MrZhouWang/HoFon-800U-R3N3/2016.07.25 800U-R3N3/hardware/2016.08.11/800U R3N3_LED_V1.0(1).PcbDoc.htm

Reporting Options

# File in Previous Format

Date | : | 2016/8/28
Time | : | 8:42:52
Filename | : | E:\公司项目\2016.07.25 800U-R3N3\hardware\2016.08.11\800U R3N3_LED_V1.0(1).PcbDoc

Version | Warning
Altium Designer update 19 | CAUTION - Air Gap Width attribute was introduced to Polygon Connect Style Rule. Air Gap Width attribute now controls the distance between poured polygon and pads on the same net - this value was previosuly taken from clearance rule while ignoring net subscope leading to sometime unexpected results.
Release 13 | CAUTION - Silkscreen Over Component Pads Rules are converted to Silk To Solder Mask Clearance Rules. Suggest examining rule scopes for accuracy.

This file was generated by an earlier version of the software
