MrZhouWang/HoFon-800U-R3N3/2016.07.25 800U-R3N3/hardware/M18图纸/M18PNP新 - 副本.PCBDOC.htm

Reporting Options

# File in Previous Format

Date | : | 2016/7/25
Time | : | 11:09:03
Filename | : | E:\公司项目\800U-R3N3\M18图纸\M18PNP新 - 副本.PCBDOC

Version | Warning
Summer 09 | CAUTION - File contains old violation objects. These violations are no longer supported & will not be loaded. Please run DRC after opening this file in order to refresh the violations.
Summer 09 | CAUTION - Existing testpoint rules and settings are used as fabrication testpoint information.
Altium Designer update 19 | CAUTION - Air Gap Width attribute was introduced to Polygon Connect Style Rule. Air Gap Width attribute now controls the distance between poured polygon and pads on the same net - this value was previosuly taken from clearance rule while ignoring net subscope leading to sometime unexpected results.
Release 13 | CAUTION - Silkscreen Over Component Pads Rules are converted to Silk To Solder Mask Clearance Rules. Suggest examining rule scopes for accuracy.

This file was generated by an earlier version of the software
