MrZhouWang/HoFon-800U-R3N3/2016.07.25 800U-R3N3/documents/800U R3N3_SENSOR_V1.3 BOM表.xlsx

 |  |  |  |  |  |  |  | 表 号
 |  |  |  |  |  |  |  | 版本/换页
 |  |  |  |  |  |  |  | 页 码 | /
产品名称 |  | 800U R3N3 |  |  | 产品型号 | 800U R3N3_SENSOR_V1.3 |  | 编制/日期 | 201608019
版本号 |  |  |  |  | 物料类别 | 电子料 |  | 审批/日期
序号 | 物料编号 |  | 物料名称 | 规格、型号 |  | 封装 | 位号 |  | 数量 | 备注
 |  |  | 800U R3N3_ SONSER_V1.3 | FR4 |  |  |  |  | 1
 |  |  | 发射二极管 | SIR67-21C |  | 3528 | LED1 |  | 1 | 亿光
 |  |  | 接收二极管 | PD70-01C |  |  | RE1 |  | 1 | 亿光
 |  |  | 贴片三极管 | MMBT5551 |  | SOT-23 | Q1 |  | 1
 |  |  | 贴片电容 | 1uF/50V |  | C0603 | C1 C2 |  | 2
 |  |  | 贴片电容 | 1nF |  | C0603 | C3 |  | 1
 |  |  | 贴片电阻 | 10K |  | R0603 | R4 |  | 1
 |  |  | 贴片电阻 | 100R |  | R0805 | R1 R2 |  | 2
 |  |  | 贴片电阻 | 50R |  | R0805 | R5 |  | 1
