MrZhouWang/HoFon-800U-R3N3/2016.07.25 800U-R3N3/hardware/原理图/800U-R3N3-Test.xls

Description | Comment | Footprint | Quantity | Designator
贴片电容 | 105 | C0805 | 1 | C1
贴片电容 | 105 | C0603 | 2 | C2, C10
贴片电容 | 104 | C0603 | 4 | C3, C7, C9, C14
贴片电容 | 102 | C0603 | 4 | C4, C5, C6, C8
贴片电容 | 1uF/50V | C0603 | 1 | C11
贴片电容 | 10uF | C0603 | 2 | C12, C13
贴片RBG发光管 | 5050RGB | 5050RGB | 8 | D1, D2, D3, D4, D5, D6, D7, D8
贴片桥堆 | LX10M | 桥堆 3.8*3.5 | 1 | D9
贴片TVS | TVS36V | D1206 | 2 | D10, D11
贴片红外发射管 | SIR67-21C | LED-3.5X2.8 | 1 | LED1
 |  | HOLE_SMD | 4 | OUT1, SIN1, VIN+1, VIN-1
插座 | 3P 2.0mm | PIN3-2.0mm | 1 | P1
贴片NPN三极管 | MMBT5551 | SOT-23 | 5 | Q1, Q2, Q3, Q4, Q6
贴片PNP三极管 | S8550 | SOT-23 | 1 | Q5
NPN三极管 | 贴片三极管 | SOT-23 | 1 | Q7
贴片电阻 | 100 | R0805 | 1 | R1
贴片电阻 | 100 | R0603 | 1 | R2
贴片电阻 | 390K | R0603 | 1 | R3
贴片电阻 | 100K | R0603 | 1 | R4
贴片电阻 | 0R | R0603 | 9 | R5, R6, R22, R24, R26, R34, R36, R38, R53
贴片电阻 | 10K | R0603 | 10 | R7, R8, R10, R42, R43, R44, R45, R47, R48, R51
贴片电阻 | 22 | R0603 | 1 | R9
贴片电阻 | 5K6 | R0603 | 2 | R11, R14
贴片电阻 | 2K | R0603 | 2 | R12, R54
贴片电阻 | 15 | R0805 | 1 | R13
贴片电阻 | 510 | 2010 | 2 | R15, R27
贴片电阻 | 300 | 2010 | 4 | R16, R17, R28, R29
贴片电阻 |  | 2010 | 6 | R18, R19, R20, R30, R31, R32
贴片电阻 |  | R0603 | 6 | R21, R23, R25, R33, R35, R37
贴片电阻 | 150 | 2010 | 3 | R39, R40, R41
贴片电阻 | 750R | 2010 | 1 | R46
贴片电阻 | 240 | R0603 | 1 | R49
贴片过流保护 | SMD1206P016 | 1206 | 2 | R50, R52
贴片电阻 | 400 | R0603 | 1 | R55
贴片接收管 | PD70-01C | LED-1210 | 1 | RE1
贴片可调电阻 |  | POT4MM-2 | 1 | RJ1
贴片芯片 | TP2312 | SO-8 | 1 | U1
贴片芯片 | C8051F300 | IC3-3-14P | 1 | U2
贴片芯片 | LM317AEMP | MP04A_N | 1 | U3
