MrZhouWang/HoFon-800U-R3N3/2016.07.25 800U-R3N3/生产输出/800U R3N3_LED_V1.3 BOM表.xlsx

物料清单（BOM） |  |  |  |  |  |  |  | 表 号
 |  |  |  |  |  |  |  | 版本/换页
 |  |  |  |  |  |  |  | 页 码 | /
产品名称 |  | 800U R3N3 |  |  | 产品型号 | 800U R3N3_LED_V1.3 |  | 编制/日期 | 20160819
版本号 |  |  |  |  | 物料类别 | 电子料 |  | 审批/日期
序号 | 物料编号 |  | 物料名称 | 规格、型号 |  | 封装 | 位号 |  | 数量 | 备注
1 |  |  | 800U R3N3_ LED_V1.3 | FR4 |  |  |  |  | 1
2 |  |  | 贴片芯片 | C8051F300 |  | QFN-11 | U2 |  | 1
3 |  |  | 贴片芯片 | OPA2337 |  | SOP-8 | U3 |  | 1 | TI
4 |  |  | 贴片芯片 | L22674 |  | SO-1.27-9/4.0 | U1 |  | 1
5 |  |  | 贴片芯片 | SP6205 |  | SOT-23-5 | U4 |  | 1
7 |  |  | 贴片三极管 | MMBT5551 |  | SOT-23 | Q1 Q6 |  | 2
8 |  |  | MOS管 | SI2301CDS |  | SOT-23 | Q3 Q4 Q5 |  | 3
9 |  |  | 桥堆 | LX10M |  |  | D4 |  | 1
10 |  |  | 贴片二极管 | SS14 |  | SMB | D1 |  | 1
11 |  |  | 贴片二极管 | TVS36V |  | HSMA | D2 D3 |  | 2
12 |  |  | 贴片电感 | 68uH |  | L-6X6 | L1 |  | 1
13 |  |  | 贴片发光二极管 | 5050RGB |  | 5050 | D5 D6 D7 D8 D9 D10 D11 D12 |  | 8
14 |  |  | 可恢复保险丝 | FSMD012-1206-R |  | R1206 | F1 F2 |  | 2
15 |  |  | 贴片电容 | 33uF/16V |  | CT3528 | C2 |  | 1
16 |  |  | 直插铝电解电容 | 22uF/50V |  | 5*11 | CT1 |  | 1
17 |  |  | 贴片电容 | 4.7uF |  | C0603 | C13 C14 |  | 2
18 |  |  | 贴片电容 | 1uF/50V |  | C0603 | C7 |  | 1
19 |  |  | 贴片电容 | 100nF |  | C0603 | C4 C9 C10 C11 C12 |  | 5
20 |  |  | 贴片电容 | 10nF |  | C0603 | C1 C3 |  | 2
21 |  |  | 贴片电容 | 1nF |  | C0603 | C5 C6 C8 |  | 3
22 |  |  | 贴片电阻 | 0R |  | R0603 | R3 R8 R13 R30 |  | 4
23 |  |  | 贴片电阻 | 150R |  | R0805 | R17 R32 R35 R38 R41 R44 R48 R51 |  | 8
24 |  |  | 贴片电阻 | 100R |  | R0805 | R25 R31 R34 R37 R40 R43 R47 R50 |  | 8
25 |  |  | 贴片电阻 | 220R |  | R0805 | R18 R33 R36 R39 R42 R45 R49 R52 |  | 8
26 |  |  | 贴片电阻 | 1K |  | R0603 | R4 R19 R21 |  | 3
27 |  |  | 贴片电阻 | 1.62K/1% |  | R0603 | R11 |  | 1
28 |  |  | 贴片电阻 | 4.75K/1% |  | R0603 | R9 |  | 1
29 |  |  | 贴片电阻 | 10K |  | R0603 | R1 R5 R6 R12 R20 R22 R26 |  | 7
30 |  |  | 贴片电阻 | 11.8K |  | R0603 | R10 |  | 1
31 |  |  | 贴片电阻 | 100K |  | R0603 | R7 |  | 1
32 |  |  | 贴片电阻 | 100K |  | R0603 | R2 |  | 1
33 |  |  | 贴片电阻 | 4.7K |  | R0603 | R14 R16 |  | 2
34 |  |  | 贴片电阻 | 3K |  | R0603 | R27 |  | 1
35 |  |  | 贴片电阻 | 2K |  | R0603 | R15 R29 |  | 2
 | NPN输出焊接器件
36 |  |  | 贴片电阻 | 0R |  | R0603 | R28 |  | 1
注：36和37取一焊接 选择NPN或者PNP输出 按客户需求
 | PNP输出焊接器件
37 |  |  | 贴片三极管 | S8550 |  | SOT-23 | Q2 |  | 1
 |  |  | 贴片电阻 | 10K |  | R0603 | R23 R24 |  | 2
