MrZhouWang/HoFon-800U-R3N3/2016.07.25 800U-R3N3/hardware/结构/800ur3n3 2016-06-20/塑件开模/800uR3N3透镜筒_ (2).stp

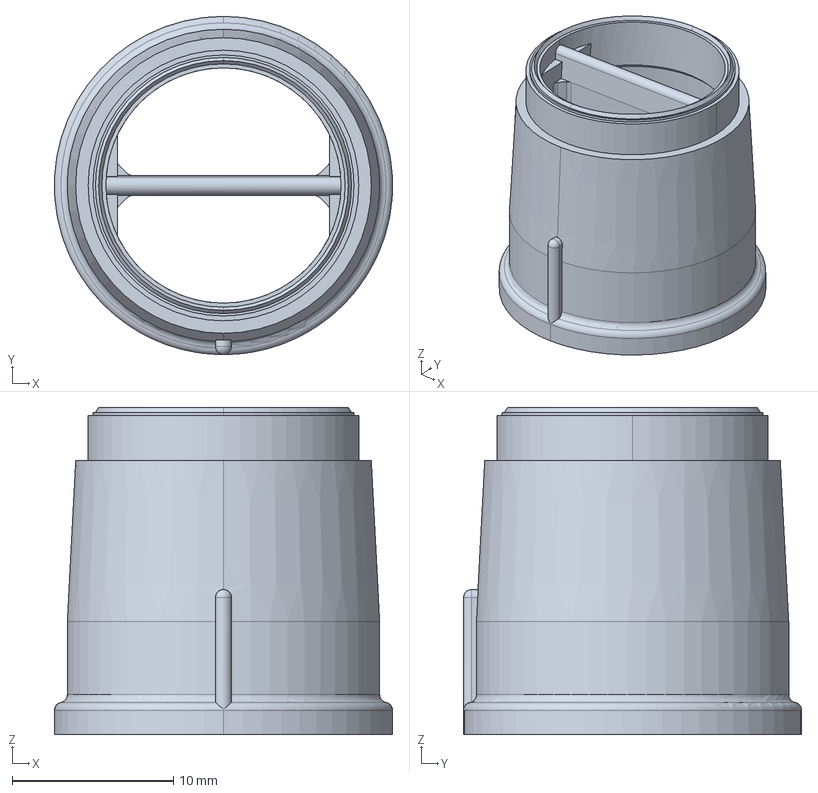
[picture p36: CAD file, 2016-11-21]
2016.07.25 800U-R3N3/hardware/结构/800ur3n3 2016-06-20/塑件开模/800uR3N3透镜筒_ (2).stp
21.0 x 21.0 x 20.3 mm
