MrZhouWang/HoFon-800U-R3N3/2016.07.25 800U-R3N3/hardware/结构/800ur3n32016-07-01/塑件开模/800u_r3n3__灯罩.stp

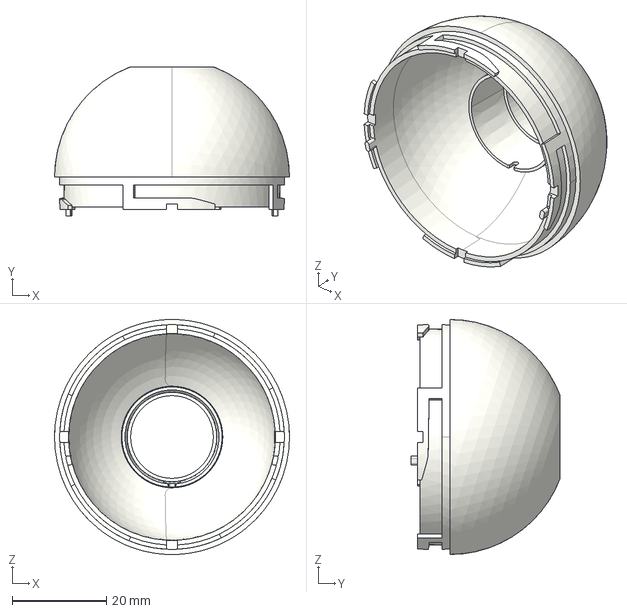
[picture p37: CAD file, 2016-11-21]
2016.07.25 800U-R3N3/hardware/结构/800ur3n32016-07-01/塑件开模/800u_r3n3__灯罩.stp
50.0 x 31.8 x 50.0 mm
