MrZhouWang/HoFon-800U-R3N3/2016.07.25 800U-R3N3/hardware/结构/塑件开模/800UR3N3透镜.stp

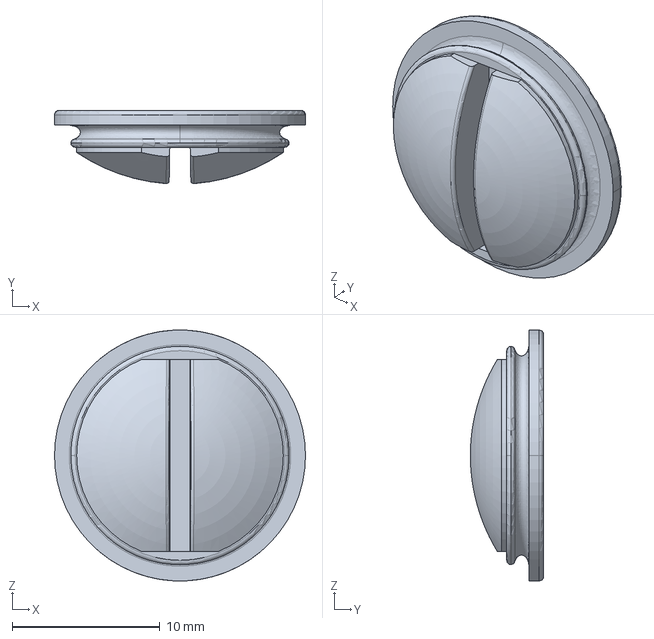
[picture p38: CAD file, 2016-11-21]
2016.07.25 800U-R3N3/hardware/结构/塑件开模/800UR3N3透镜.stp
17.0 x 4.96 x 17.0 mm
