MrZhouWang/HoFon-800U-R3N3/2016.07.25 800U-R3N3/hardware/结构/800ur3n3 2016-06-20/塑件开模/800u___按键灯罩 (2).stp

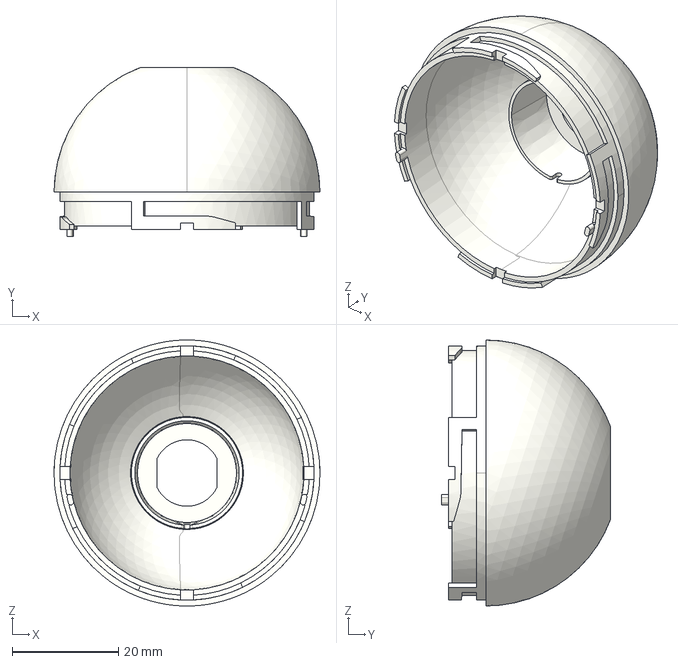
[picture p39: CAD file, 2016-11-21]
2016.07.25 800U-R3N3/hardware/结构/800ur3n3 2016-06-20/塑件开模/800u___按键灯罩 (2).stp
50.0 x 31.9 x 50.0 mm
