MrZhouWang/HoFon-800U-R3N3/2016.07.25 800U-R3N3/hardware/结构/800ur3n32016-07-01/塑件开模/800uR3N3透镜筒.stp

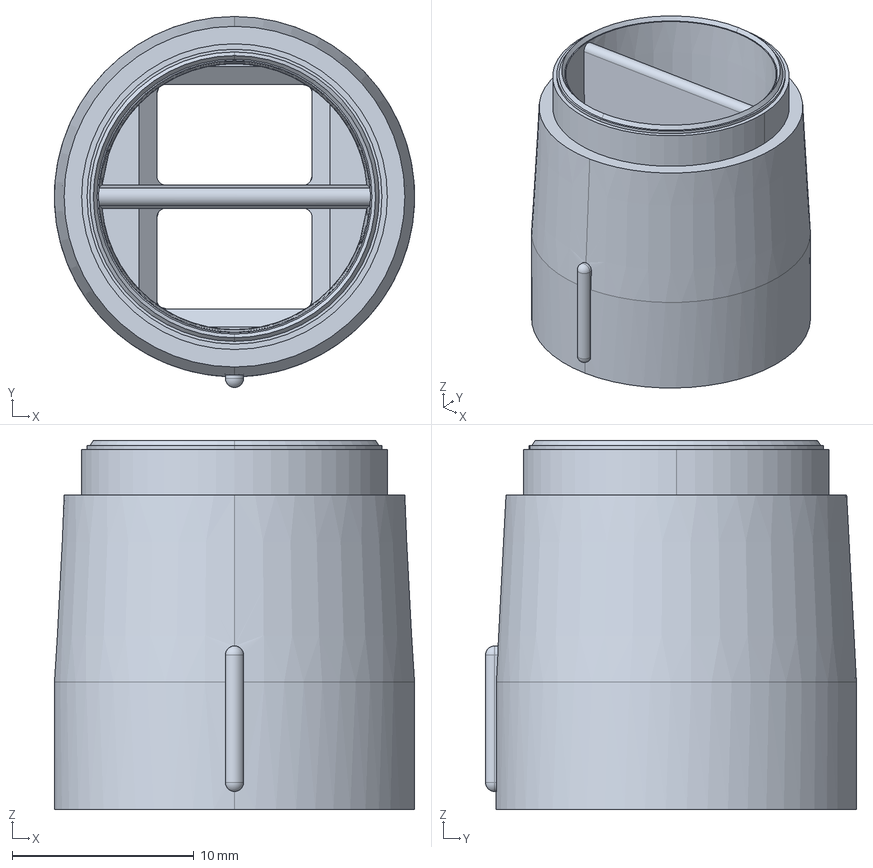
[picture p40: CAD file, 2016-11-21]
2016.07.25 800U-R3N3/hardware/结构/800ur3n32016-07-01/塑件开模/800uR3N3透镜筒.stp
19.8 x 20.4 x 20.3 mm
