MrZhouWang/HoFon-800U-R3N3/2016.07.25 800U-R3N3/hardware/结构/800ur3n3 2016-06-20/塑件开模/800UR3N3透镜 (2).stp

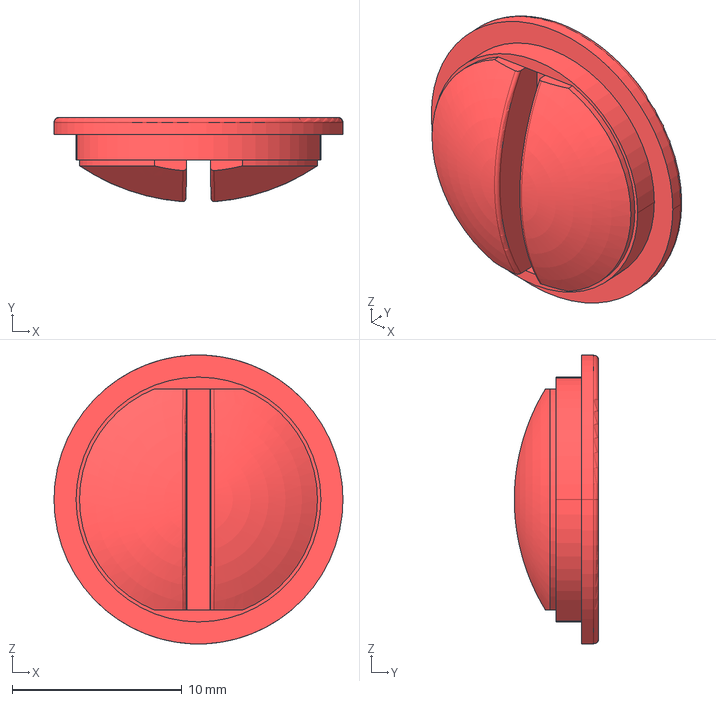
[picture p41: CAD file, 2016-11-21]
2016.07.25 800U-R3N3/hardware/结构/800ur3n3 2016-06-20/塑件开模/800UR3N3透镜 (2).stp
17.0 x 4.96 x 17.0 mm
