MrZhouWang/HoFon-800U-R3N3/2016.07.25 800U-R3N3/hardware/结构/800ur3n32016-07-01/塑件开模/800UR3N3透镜.stp

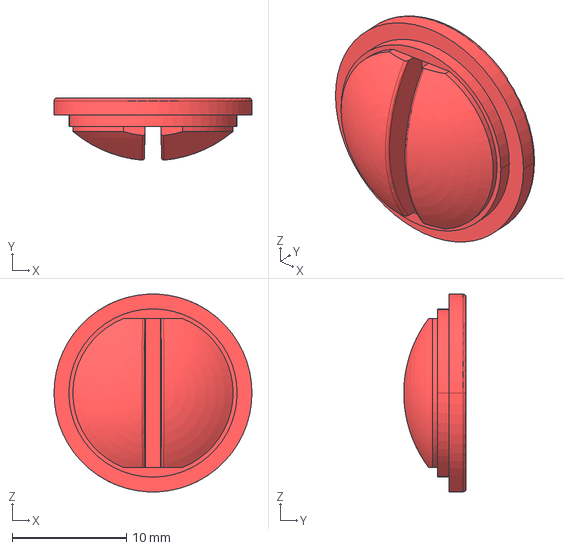
[picture p42: CAD file, 2016-11-21]
2016.07.25 800U-R3N3/hardware/结构/800ur3n32016-07-01/塑件开模/800UR3N3透镜.stp
17.3 x 5.46 x 17.3 mm
