MrZhouWang/HoFon-800U-R3N3/(list of files, cad)

Other CAD files:
2016.07.25 800U-R3N3/firmware/800U-P3N3-T3N3 IO_V2.1_20151013 定制/UV4/main.obj
2016.07.25 800U-R3N3/firmware/800U-R3B3程序 - 2016-8-18/PRO/main.obj
2016.07.25 800U-R3N3/firmware/800U-R3B3程序 - 2016-8-08/PRO/main.obj
2016.07.25 800U-R3N3/firmware/800U-R3B3程序 - 2016-9-11/PRO/main.obj
2016.07.25 800U-R3N3/firmware/800U-R3B3程序 - 2016-10-26-绝对值/PRO/main.obj
2016.07.25 800U-R3N3/documents/800U-R3N3/程序 - 2016-6-30/800U-R3N3.obj
2016.07.25 800U-R3N3/firmware/800U-P3N3-T3N3 IO_V2.1_20151013 定制/UV4/CBM7008.obj
2016.07.25 800U-R3N3/firmware/800U-R3B3程序 - 2016-10-26-绝对值/PRO/STARTUP.OBJ
2016.07.25 800U-R3N3/firmware/800U-R3B3程序 - 2016-6-30/800U-R3N3.obj
2016.07.25 800U-R3N3/firmware/800U-R3B3程序 - 2016-7-26/800U-R3N3.obj
2016.07.25 800U-R3N3/firmware/800U-R3B3程序 - 2016-8-08/PRO/adc.obj
2016.07.25 800U-R3N3/firmware/800U-R3B3程序 - 2016-8-18/PRO/led.obj
2016.07.25 800U-R3N3/firmware/800U-R3B3程序 - 2016-9-11/PRO/STARTUP.OBJ
2016.07.25 800U-R3N3/firmware/800U-R3B3程序/STARTUP.obj
2016.07.25 800U-R3N3/hardware/结构/800u-R3N3pcb2.dwg
2016.07.25 800U-R3N3/hardware/结构/800ur3n3 2016-06-20/800u-R3N3pcb2.dwg
2016.07.25 800U-R3N3/hardware/结构/800ur3n32016-07-01/800u-R3N3pcb2.dwg
2016.07.25 800U-R3N3/documents/800U-R3N3/程序 - 2016-6-30/STARTUP.obj
2016.07.25 800U-R3N3/firmware/800U-R3B3程序 - 2016-10-26-绝对值/PRO/init.obj
2016.07.25 800U-R3N3/firmware/800U-R3B3程序 - 2016-6-30/STARTUP.obj
2016.07.25 800U-R3N3/firmware/800U-R3B3程序 - 2016-7-26/STARTUP.obj
2016.07.25 800U-R3N3/firmware/800U-R3B3程序 - 2016-8-08/PRO/init.obj
2016.07.25 800U-R3N3/firmware/800U-R3B3程序 - 2016-8-18/PRO/delay.obj
2016.07.25 800U-R3N3/firmware/800U-R3B3程序 - 2016-9-11/PRO/timer.obj
2016.07.25 800U-R3N3/firmware/800U-R3B3程序/800U-R3N3.obj
2016.07.25 800U-R3N3/hardware/结构/800u-R3N3pcb.dwg
2016.07.25 800U-R3N3/hardware/结构/800ur3n3 2016-06-20/800u-R3N3pcb.dwg
2016.07.25 800U-R3N3/hardware/结构/800ur3n32016-07-01/800u-R3N3pcb.dwg
2016.07.25 800U-R3N3/hardware/结构/800ur3n32016-07-01/塑件开模/800u___按键灯罩.stp
2016.07.25 800U-R3N3/hardware/结构/塑件开模/800u_r3n3__灯罩.stp
2016.07.25 800U-R3N3/firmware/800U-R3B3程序 - 2016-10-26-绝对值/PRO/timer.obj
2016.07.25 800U-R3N3/firmware/800U-R3B3程序 - 2016-8-08/PRO/delay.obj
2016.07.25 800U-R3N3/firmware/800U-R3B3程序 - 2016-8-18/PRO/adc.obj
2016.07.25 800U-R3N3/firmware/800U-R3B3程序 - 2016-9-11/PRO/delay.obj
2016.07.25 800U-R3N3/hardware/结构/800ur3n3 2016-06-20/塑件开模/800u_r3n3__灯罩 (2).stp
2016.07.25 800U-R3N3/hardware/结构/塑件开模/800u___按键灯罩.stp
2016.07.25 800U-R3N3/firmware/800U-R3B3程序 - 2016-10-26-绝对值/PRO/delay.obj
2016.07.25 800U-R3N3/firmware/800U-R3B3程序 - 2016-8-08/PRO/led.obj
2016.07.25 800U-R3N3/firmware/800U-R3B3程序 - 2016-8-18/PRO/init.obj
2016.07.25 800U-R3N3/firmware/800U-R3B3程序 - 2016-9-11/PRO/init.obj
2016.07.25 800U-R3N3/hardware/结构/塑件开模/800uR3N3透镜筒_.stp
2016.07.25 800U-R3N3/firmware/800U-R3B3程序 - 2016-10-26-绝对值/PRO/adc.obj
2016.07.25 800U-R3N3/firmware/800U-R3B3程序 - 2016-8-08/PRO/timer.obj
2016.07.25 800U-R3N3/firmware/800U-R3B3程序 - 2016-8-18/PRO/timer.obj
2016.07.25 800U-R3N3/firmware/800U-R3B3程序 - 2016-9-11/PRO/led.obj
2016.07.25 800U-R3N3/firmware/800U-R3B3程序 - 2016-10-26-绝对值/PRO/exti.obj
2016.07.25 800U-R3N3/firmware/800U-R3B3程序 - 2016-8-08/PRO/STARTUP.OBJ
2016.07.25 800U-R3N3/firmware/800U-R3B3程序 - 2016-9-11/PRO/exti.obj
2016.07.25 800U-R3N3/firmware/800U-R3B3程序 - 2016-10-26-绝对值/PRO/led.obj
2016.07.25 800U-R3N3/firmware/800U-R3B3程序 - 2016-8-18/PRO/STARTUP.OBJ
2016.07.25 800U-R3N3/firmware/800U-R3B3程序 - 2016-9-11/PRO/adc.obj
2016.07.25 800U-R3N3/firmware/800U-R3B3程序 - 2016-10-26-绝对值/PRO/DWG.obj
2016.07.25 800U-R3N3/firmware/800U-R3B3程序 - 2016-8-08/PRO/exti.obj
2016.07.25 800U-R3N3/firmware/800U-R3B3程序 - 2016-8-18/PRO/key.obj
2016.07.25 800U-R3N3/firmware/800U-R3B3程序 - 2016-9-11/PRO/key.obj
2016.07.25 800U-R3N3/firmware/800U-R3B3程序 - 2016-10-26-绝对值/PRO/key.obj
2016.07.25 800U-R3N3/firmware/800U-R3B3程序 - 2016-8-18/PRO/exti.obj
