MrZhouWang/HoFon-800U-R3N3/2016.07.25 800U-R3N3/firmware/800U-R3B3程序 - 2016-10-26-绝对值/PRO/调试笔记.txt

2016.08.17
	基本实现开关要求，还需进一步调试抗干扰性能。
2016.08.18
    实现10cm检测要求 ，下一步调试INPUT/OUTPUT功能。
2016.08.19
    实现基本的按键灯光显示机制。
2016.08.20
	上电时采集初始基准电压,完善闪烁机制。
