MrZhouWang/HoFon-800U-R3N3/2016.07.25 800U-R3N3/hardware/2016.08.25/800U-R3N3_LED_V1.1.pdf

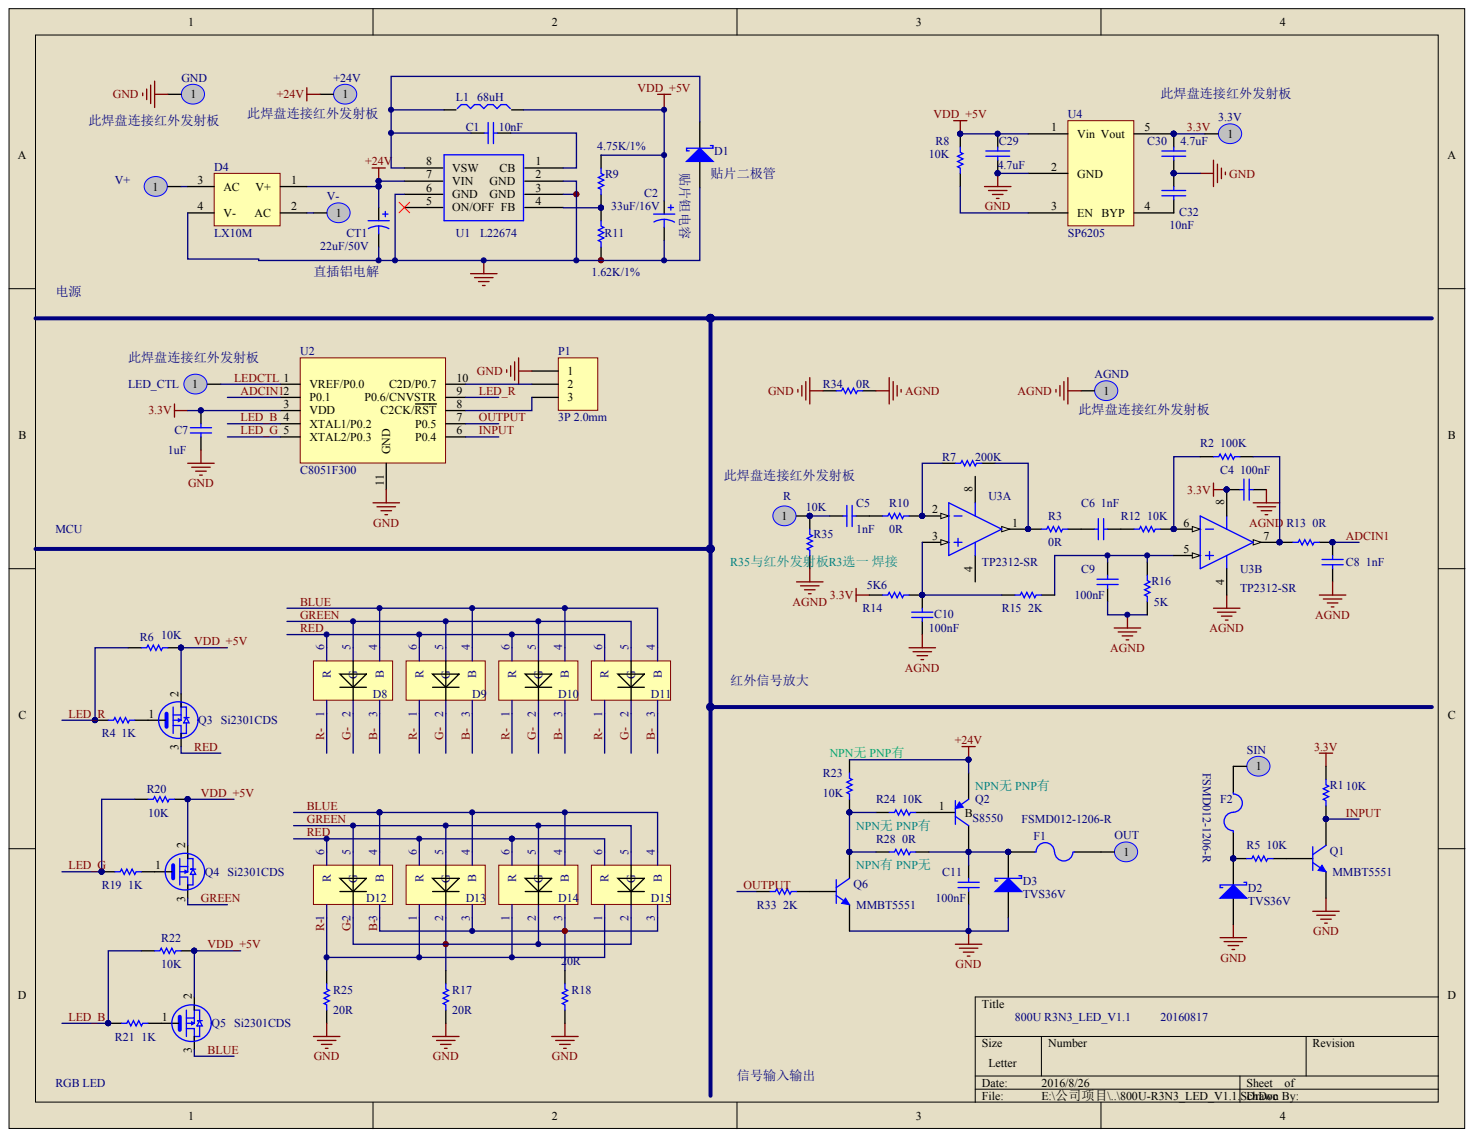
[picture p43: page 1]

GND 6 VIN 7 VSW 8 FB GND GND | 4 ON/OFF 5 2

GREEN
RED
