MrZhouWang/HoFon-800U-R3N3/2016.07.25 800U-R3N3/hardware/2016.09.10/800U R3N3_SONSER_V1.0.pdf

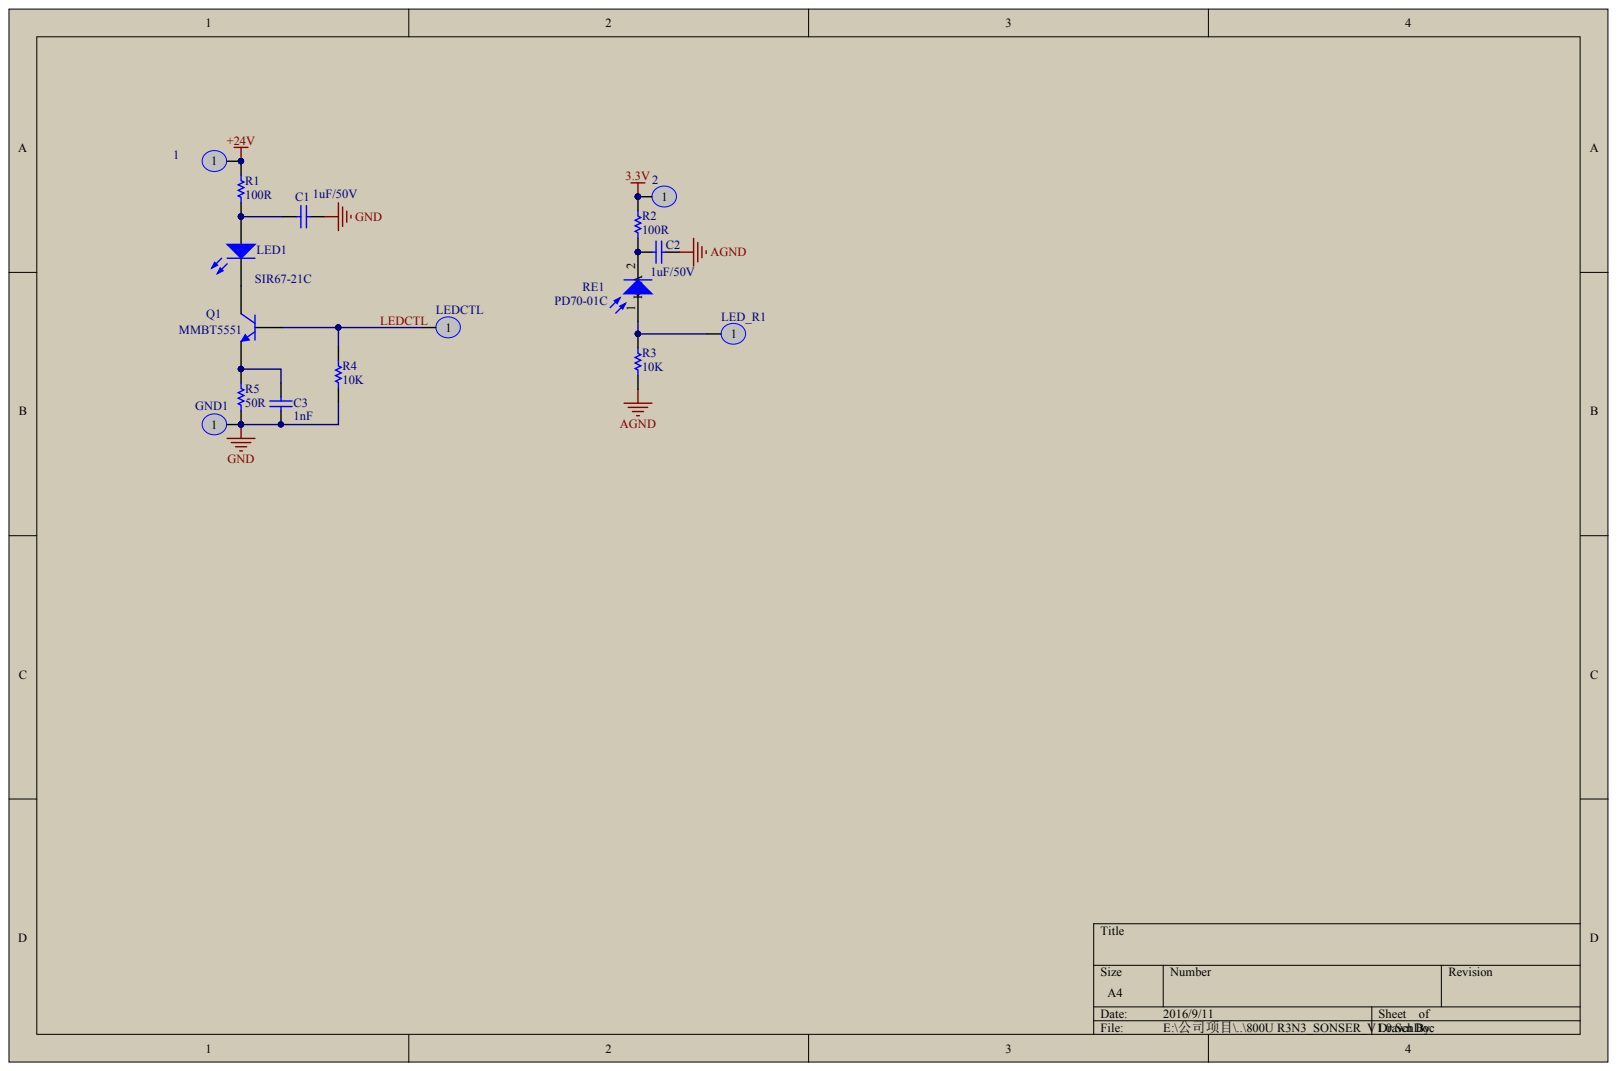
[picture p44: page 1]
