MrZhouWang/HoFon-800U-R3N3/2016.07.25 800U-R3N3/hardware/2016.09.10/800U-R3N3_LED_V1.2.pdf

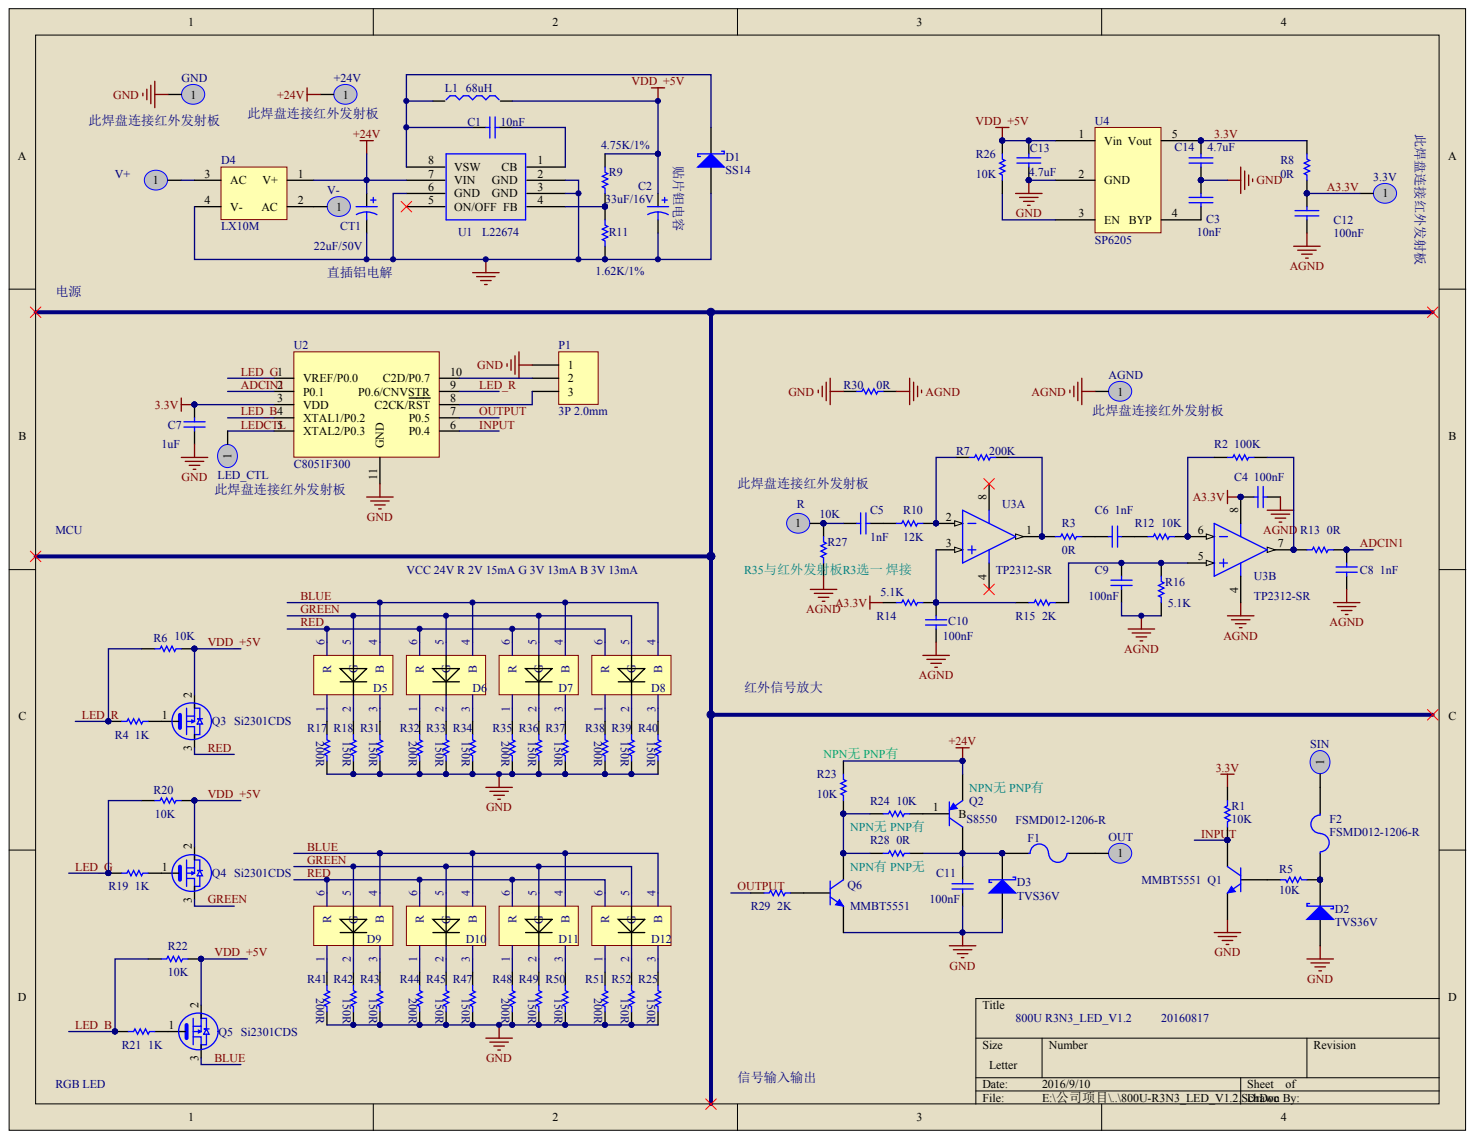
[picture p45: page 1]

GREEN
RED
