MrZhouWang/HoFon-800U-R3N3/2016.07.25 800U-R3N3/hardware/原理图/800U-R3N3-Test.pdf

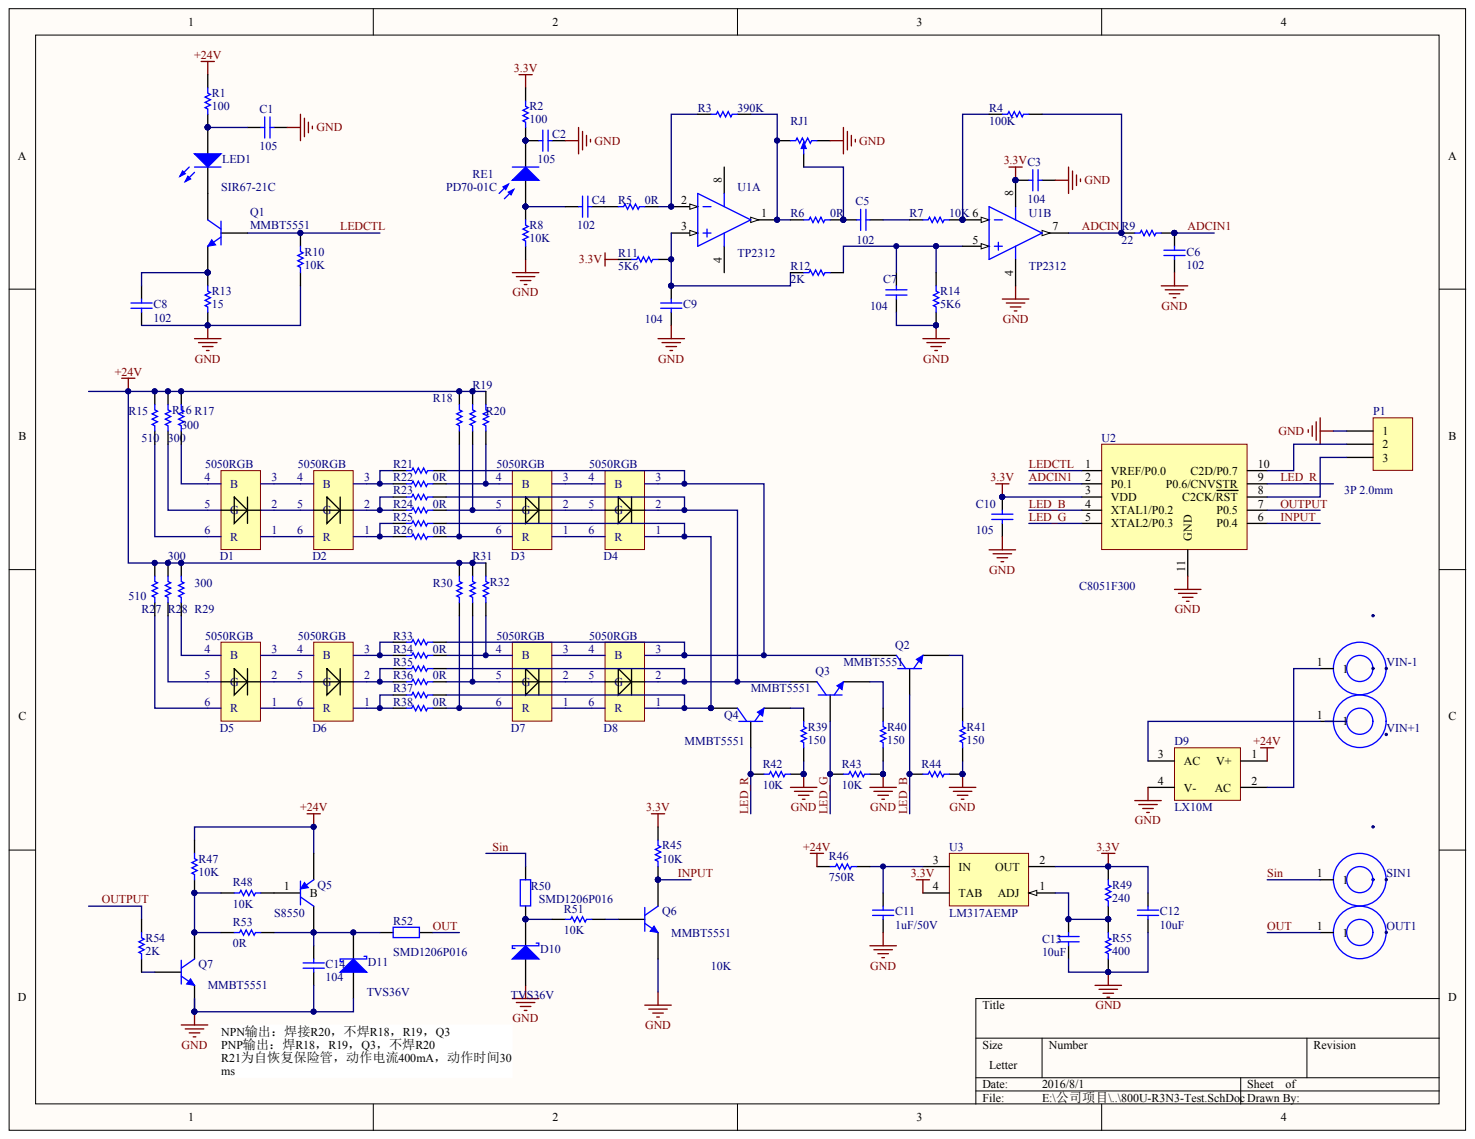
[picture p46: page 1]
