MrZhouWang/HoFon-800U-R3N3/(list of files, drawings)

Other design files:
2016.07.25 800U-R3N3/documents/800U-R3N3/M18图纸/m18.PcbDoc
2016.07.25 800U-R3N3/documents/800U-R3N3/M18图纸/m18.PcbLib
2016.07.25 800U-R3N3/documents/800U-R3N3/M18图纸/M18_lcq_20140714.SchDoc
2016.07.25 800U-R3N3/documents/800U-R3N3/M18图纸/M18_lcq_20140714.SCHLIB
2016.07.25 800U-R3N3/documents/800U-R3N3/M18图纸/M18PNP新 - 副本.PCBDOC
2016.07.25 800U-R3N3/documents/800U-R3N3/M18图纸/m181.PcbLib
2016.07.25 800U-R3N3/documents/800U-R3N3/M18图纸/PCB_Project1.PrjPCB
2016.07.25 800U-R3N3/hardware/800Usensor/800U R3N3_SENSOR_V1.0.PcbDoc
2016.07.25 800U-R3N3/hardware/800Usensor/800U R3N3_SONSER_V1.0.SchDoc
2016.07.25 800U-R3N3/hardware/800Usensor/800U-R3N3_V1.0.SchDoc
2016.07.25 800U-R3N3/hardware/2016.08.11/800U R3N3_LED_V1.0.PcbDoc
2016.07.25 800U-R3N3/hardware/2016.08.11/800U-R3N3_V1.0.SchDoc
2016.07.25 800U-R3N3/hardware/2016.08.25/800U R3N3_LED_V1.1.PcbDoc
2016.07.25 800U-R3N3/hardware/2016.08.25/800U R3N3_SENSOR_V1.2.PcbDoc
2016.07.25 800U-R3N3/hardware/2016.08.25/800U R3N3_SONSER_V1.0.SchDoc
2016.07.25 800U-R3N3/hardware/2016.08.25/800U-R3N3_LED_V1.1.SchDoc
2016.07.25 800U-R3N3/hardware/2016.09.10/800U R3N3_LED_V1.2.PcbDoc
2016.07.25 800U-R3N3/hardware/2016.09.10/800U R3N3_SENSOR_V1.2.PcbDoc
2016.07.25 800U-R3N3/hardware/2016.09.10/800U R3N3_SONSER_V1.0.SchDoc
2016.07.25 800U-R3N3/hardware/2016.09.10/800U-R3N3_LED_V1.2.SchDoc
2016.07.25 800U-R3N3/hardware/M18图纸/m18.PcbDoc
2016.07.25 800U-R3N3/hardware/M18图纸/m18.PcbLib
2016.07.25 800U-R3N3/hardware/M18图纸/M18_lcq_20140714.SchDoc
2016.07.25 800U-R3N3/hardware/M18图纸/M18_lcq_20140714.SCHLIB
2016.07.25 800U-R3N3/hardware/M18图纸/M18PNP新 - 副本.PCBDOC
2016.07.25 800U-R3N3/hardware/M18图纸/m181.PcbLib
2016.07.25 800U-R3N3/hardware/M18图纸/PCB_Project1.PrjPCB
2016.07.25 800U-R3N3/hardware/原理图/800U-R3N3-Test.PcbDoc
2016.07.25 800U-R3N3/hardware/原理图/800U-R3N3-Test.SchDoc
2016.07.25 800U-R3N3/hardware/原理图/PCB_Project1.PrjPCB
