MrZhouWang/HoFon-800U-R3N3/2016.07.25 800U-R3N3/firmware/800U-R3B3程序 - 2016-8-08/INC/main.h

#ifndef _MAIN_H_
#define _MAIN_H_

#include "include.h"



#ifdef MAIN_GLOBAL
#define EXT_MAIN
#else
#define EXT_MAIN extern
#endif

#define		FSLEDONTIME	100	 	   // 占空比打开发射管持续时间
#define		Dval	0x98	         // 差值比较
#define		Dnum	50 	           // 遮挡次数比较 

//  全局变量定义
EXT_MAIN bit		f_OUT;			  // 输出状态标志

EXT_MAIN bit		f_prossout;		// 处理一次输出标志，采集一定脉冲数再处理，TRUE 待处理



EXT_MAIN volatile INT8U	RevBase;		  // 基准电压值
EXT_MAIN volatile INT8U sampDat ;
EXT_MAIN volatile INT8U out ;
EXT_MAIN INT16U 	count;		  	      // 对10us计数，最大650ms
 




#endif
