MrZhouWang/HoFon-800U-R3N3/2016.07.25 800U-R3N3/firmware/800U-R3B3程序 - 2016-10-26-绝对值/SRC/key.c

#define KEY_GLOBAL
#include "include.h"
UINT8  KeyStatus_flag = 0;

//////////////////////////////////////////////////////////////////////////////////
//// 功能描述 : 按键状态监测
//// 输入参数 : 
//// 返回参数 : 
//// 说明     :  
//////////////////////////////////////////////////////////////////////////////////
void key_status()
{		
			 
	  if((f_prossout == TRUE)&&(AD_Base_OK == OK))                      //按键检测机制 限定是在基准采样完后再做比较
	  {	
			 f_prossout = FALSE;
			 
			 
			 if((sampDat>RevBase)&&(sampDat-RevBase)>Dval)   //判断是否为开关触发
				 out++;
			 else                 //如果遮挡时间无效 重新计时
				 out=0;	
	  }		
		if(out>Dnum)            //有按键
		{
			 out=Dnum+1;
			 KeyStatus = ON;      
		}
		else
			 KeyStatus = OFF;
}
