MrZhouWang/HoFon-800U-R3N3/2016.07.25 800U-R3N3/firmware/800U-R3B3程序 - 2016-10-26-绝对值/SRC/timer.c

 #include "include.h"

//////////////////////////////////////////////////////////////////////////////////
//// 功能描述 : 定时器0初始化
//// 输入参数 : 
//// 返回参数 : 
//// 说明     :  
//////////////////////////////////////////////////////////////////////////////////
void Timer0_Init (void)			 // 30us
{
	TR0 = 1;          //Timer0启动,即TCON=0x10;
	ET0 = 1;          //T0溢出中断允许
 	TH0 = (255-10);		//10US 
 	TMOD = 2;			    //定时器0 8bit自动重装载
 	CKCON |= 0x01;		//4分频率  6/4
	EA =0;
}
//////////////////////////////////////////////////////////////////////////////////
//// 功能描述 : 定时器0中断入口函数
//// 输入参数 : 
//// 返回参数 : 
//// 说明     :  1ms采集一次 连续采样20此大于基准电压，表示有触发
//////////////////////////////////////////////////////////////////////////////////
void Timer0(void) interrupt 1 				 //10us
{
	count++;					                   //对10us计数				

  if(LedDelayCnt>0)                    //按键关断计时
		 LedDelayCnt--;
	

		 if(ADC_BaseErrNum>0)                 
	   {
		    ADC_BaseErrNum--;
	   }

	
/********************发射处理****************************************************/	

	if(count>FSLEDONTIME)                 //持续发射
	{	
			
			pEMILEDCTL = ON;			            // 发射管打开
      count=0;
      valid_ok = TRUE;
	}
	else
	{
		 if(valid_ok == TRUE)
	   {
			// LED_B_ON;
			 sampDat = ADC_Samp(); 	         // 采集高端数据	
      // LED_B_OFF;		 
		   
			 pEMILEDCTL = OFF;			           // 发射管关闭
			 f_prossout = TRUE;               //发射一次完成
      
    
	   }
		 pEMILEDCTL = OFF;			             // 发射管关闭
	   valid_ok = FALSE;
	}

	}


//////////////////////////////////////////////////////////////////////////////////
//// 功能描述 : 定时器0开启
//// 输入参数 : 
//// 返回参数 : 
//// 说明     :  
//////////////////////////////////////////////////////////////////////////////////
void Interrupt_Init (void)
{
	EA = 1; //中断允许总控制位
}
